UkraineRobotics/Kulya/BODY/Step #1 3D printing & components/CorrectServo.png

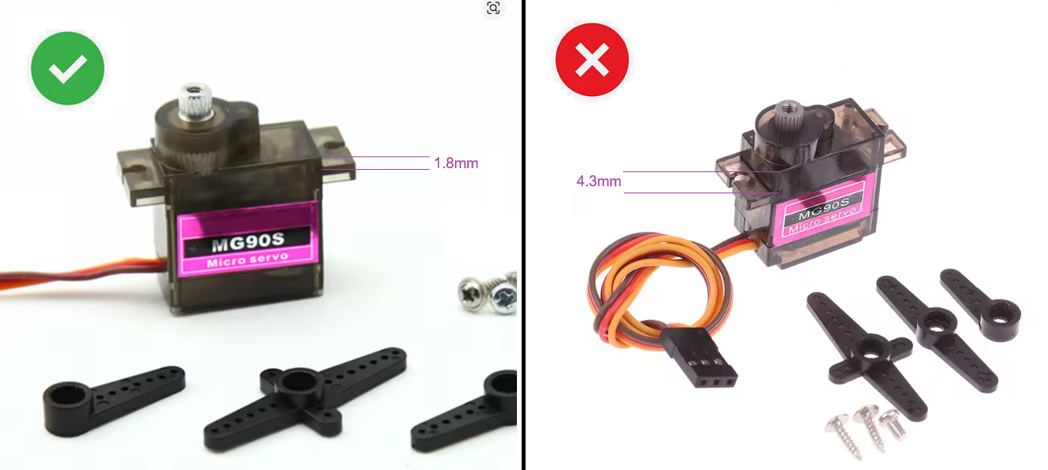
BODY/Step #1 3D printing & components/CorrectServo.png
