UkraineRobotics/Kulya/BATTERY/battery_wirnig.png

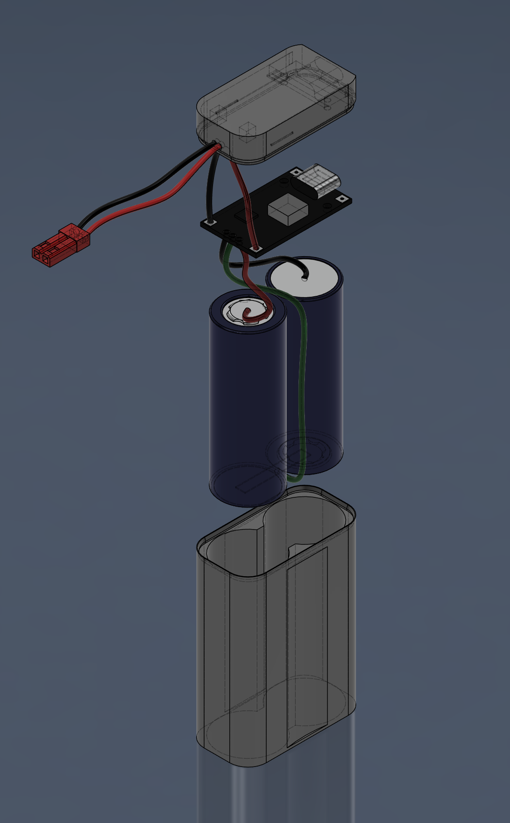
BATTERY/battery_wirnig.png
