UkraineRobotics/Kulya/CONTROLLER/Schematics/#1 rc-wires-length.png

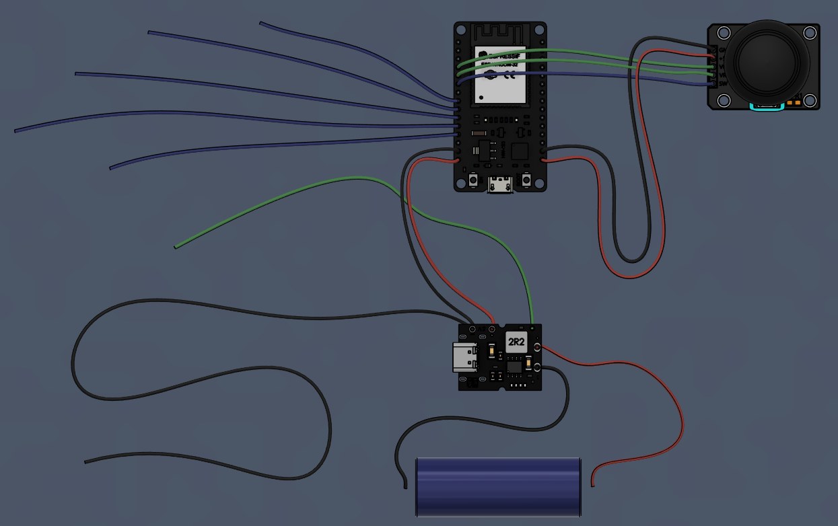
CONTROLLER/Schematics/#1 rc-wires-length.png
