UkraineRobotics/Kulya/CONTROLLER/Schematics/#2 rc-wires-in place.png

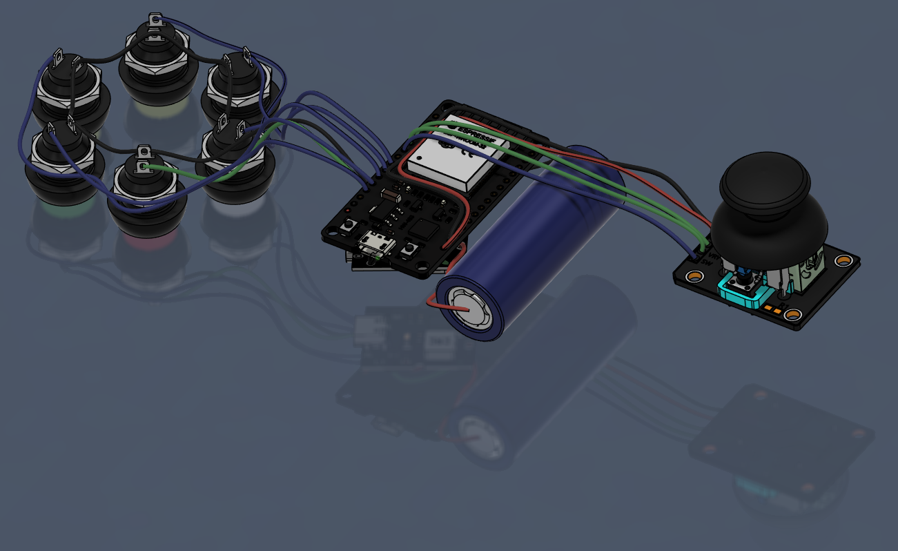
CONTROLLER/Schematics/#2 rc-wires-in place.png
