UkraineRobotics/Kulya/CONTROLLER/Schematics/#3 rc_2.png

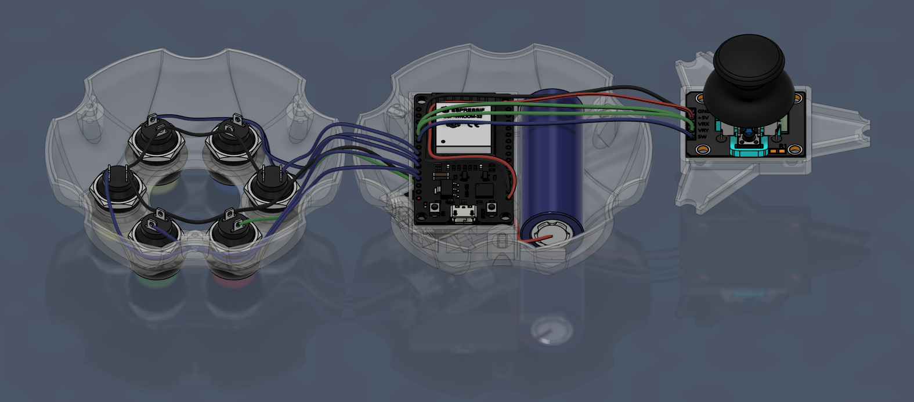
CONTROLLER/Schematics/#3 rc_2.png
