UkraineRobotics/Kulya/CONTROLLER/Schematics/#4 rc3.png

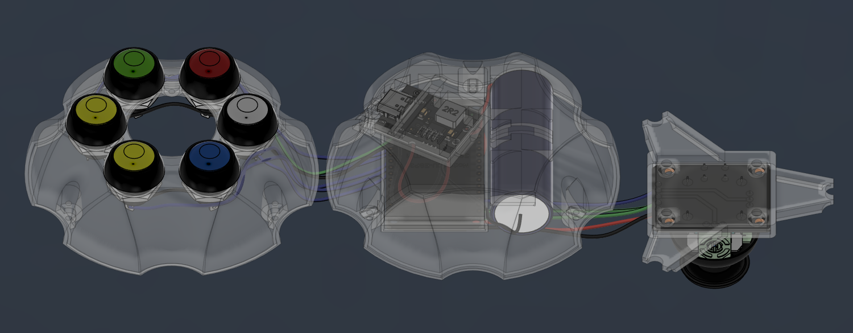
CONTROLLER/Schematics/#4 rc3.png
