UkraineRobotics/Kulya/CONTROLLER/Schematics/rc_all.png

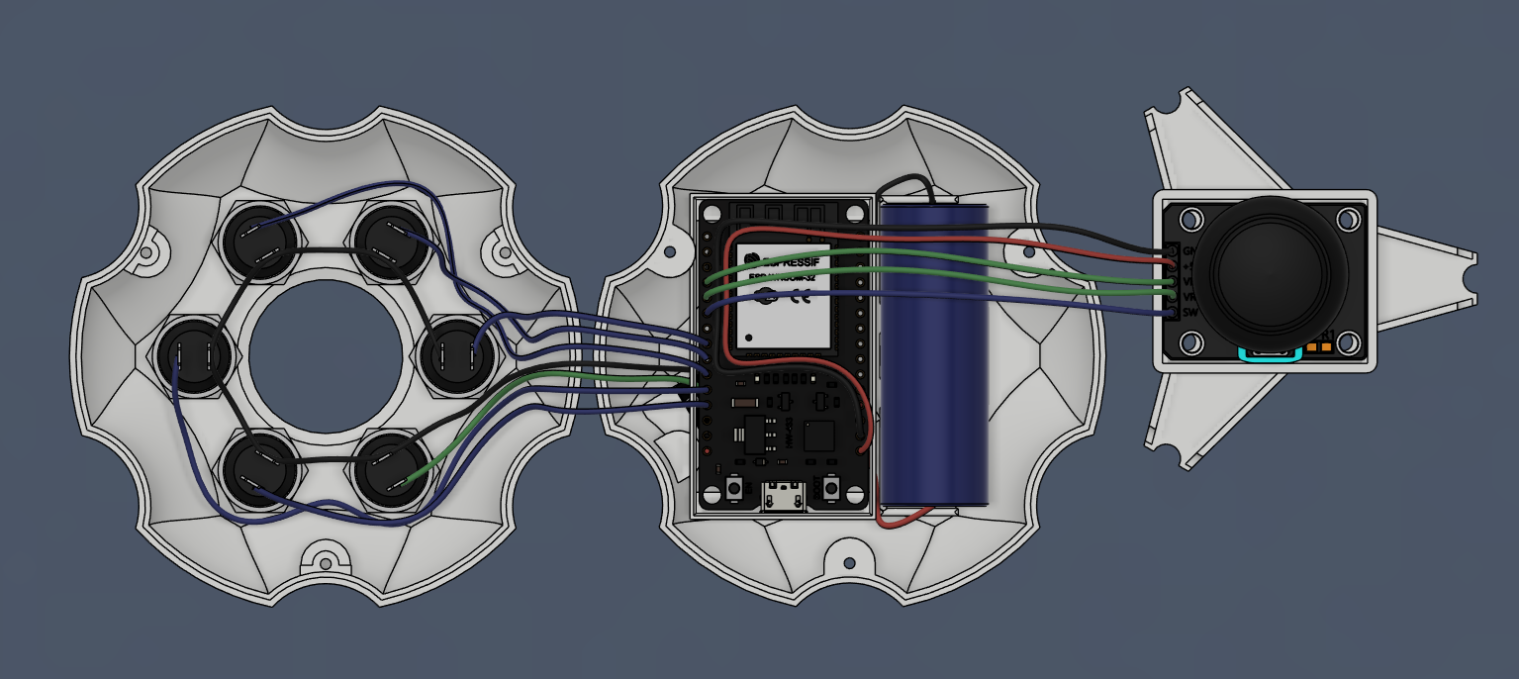
CONTROLLER/Schematics/rc_all.png
