UkraineRobotics/Kulya/BODY/Step #1 3D printing & components/[HEXAPOD KULYA 4.0] Full components list.xlsx

Kulya v4 components
 |  | DIY #1 Body | DIY #2 Battery | DIY #3 Controller
26/24/22/18 awg Mix Stranded Wire Kit | 1 | ✅ | ✅ | ✅ | https://www.aliexpress.com/item/33016312056.html
18500 2000mAh 3.7 V rechargeable battery | 3 | — | ✅ | ✅ | https://www.aliexpress.com/item/1005006411212672.html
Push Button Switch 1712KD | 1 | ✅ | — | — | 1712-KD 2P self-locking rocker switch for DIY robot builds & repairs, flashlight replacement universal decorative on/off button - AliExpress (https://www.aliexpress.com/item/1005010668273964.html)
12mm Waterproof Momentary Push button | 6 | — | — | ✅ | https://www.aliexpress.com/item/32872212158.html
arduino joystick module | 1 | — | — | ✅ | https://www.aliexpress.com/item/1005006195988088.html
esp32 | 2 | ✅ | — | ✅ | https://www.aliexpress.com/item/1005008498639616.html
DC-DC mini560 | 2 | ✅ | ✅ | — | https://www.aliexpress.com/item/1005001426023425.html
type-c BMS | 1 | — | ✅ | — | https://www.aliexpress.com/item/1005004682732678.html
5V 2A Type-C Charge-discharge Integrated Module | 1 | — | ✅ | — | https://www.aliexpress.com/item/1005008401889519.html
10-100pcs Copper Wire JST Male Female Plug Connector 2 Pin | 1 | ✅ | ✅ | ✅ | https://www.aliexpress.com/item/1005010408480405.html?srcSns=sns_Copy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
servo controller USC-1 | 1 | ✅ | — | — | https://www.aliexpress.com/item/32808592882.html
servo MG90s | 20 | ✅ | — | — | https://www.aliexpress.com/item/1005004349047152.html
