UkraineRobotics/Kulya/BATTERY/[HEXAPOD] Battery 3D models/btr_lid.3mf

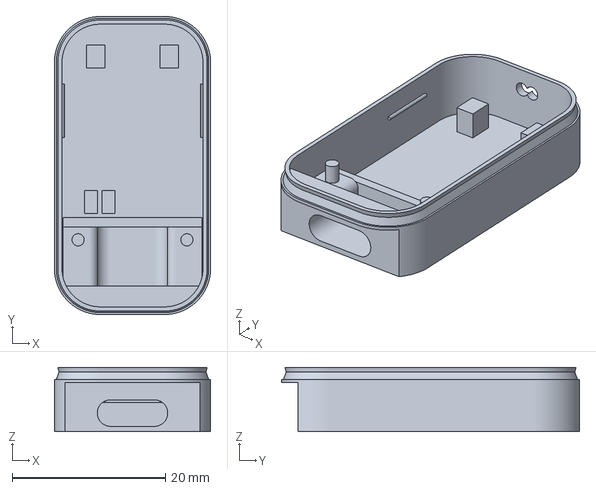
[picture p8: CAD file, 2026-03-12]
BATTERY/[HEXAPOD] Battery 3D models/btr_lid.3mf
20.4 x 38.9 x 8.40 mm
