UkraineRobotics/Kulya/BODY/Step #1 3D printing & components/3D models/femur.3mf

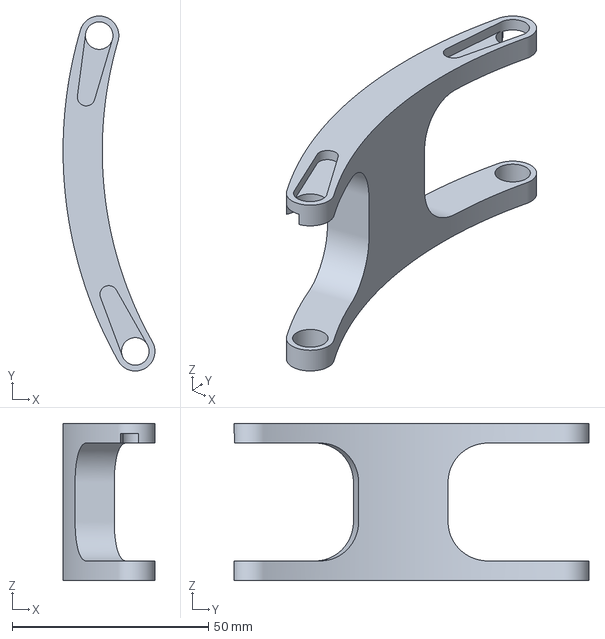
[picture p9: CAD file, 2026-03-12]
BODY/Step #1 3D printing & components/3D models/femur.3mf
23.4 x 90.4 x 40.0 mm
