UkraineRobotics/Kulya/BODY/Step #1 3D printing & components/Print Kulya_v4_all_models.3mf

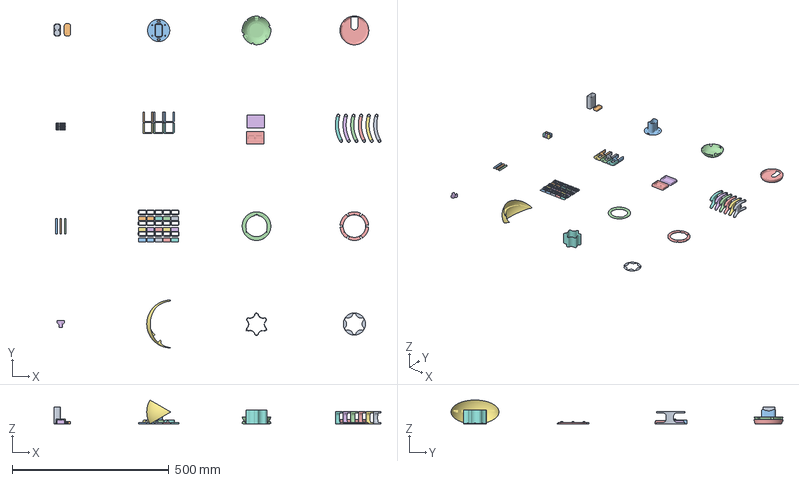
[picture p10: CAD file, 2026-03-12]
BODY/Step #1 3D printing & components/Print Kulya_v4_all_models.3mf
1042.7 x 1058.5 x 76.3 mm
btr_case
btr_lid
battery_module
cap_bottom
cap_top
connector x 6
leg-seg-base-short x 6
dcdc_pocket
esp_pocket
femur x 6
pole1 x 3
Assembly x 15
base_lower_ring
RING_top
switch holder
Tibia
outer_shell
tubu_cap
