UkraineRobotics/Kulya/BATTERY/[HEXAPOD] Battery 3D models/btr_case.3mf

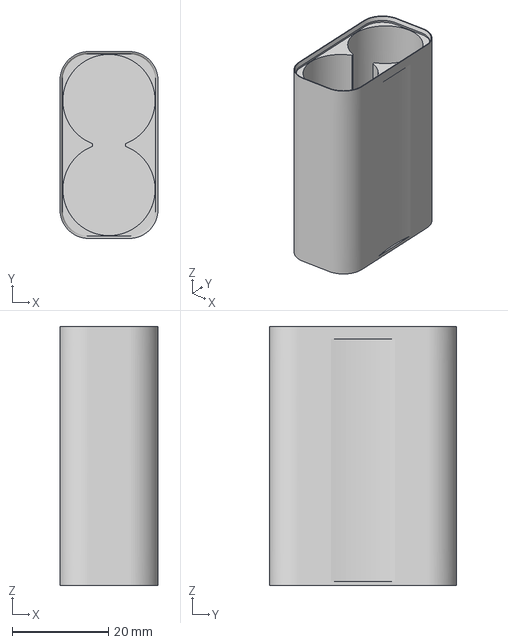
[picture p12: CAD file, 2026-03-12]
BATTERY/[HEXAPOD] Battery 3D models/btr_case.3mf
20.4 x 38.9 x 53.9 mm
