UkraineRobotics/Kulya/BODY/Step #1 3D printing & components/3D models/CAP_top_enforced.3mf

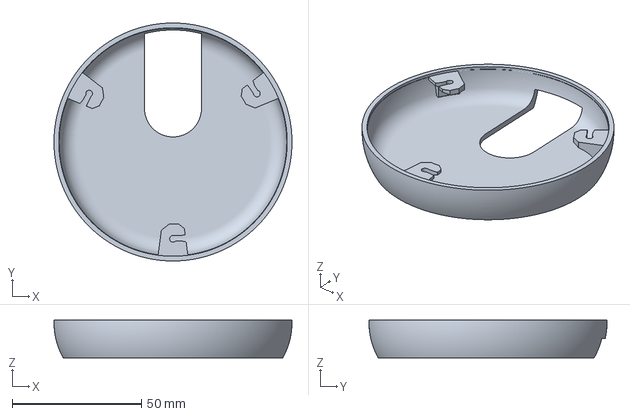
[picture p13: CAD file, 2026-03-12]
BODY/Step #1 3D printing & components/3D models/CAP_top_enforced.3mf
92.0 x 92.0 x 14.5 mm
