UkraineRobotics/Kulya/CONTROLLER/RemoteControl 3D models/RC_Bottom.3mf

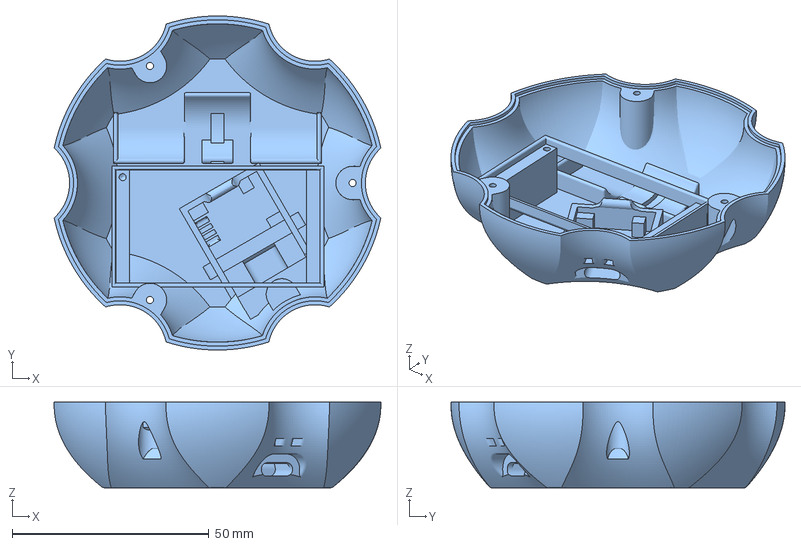
[picture p14: CAD file, 2026-03-12]
CONTROLLER/RemoteControl 3D models/RC_Bottom.3mf
83.1 x 85.0 x 21.8 mm
