UkraineRobotics/Kulya/BODY/Step #1 3D printing & components/3D models/tubus_cap.3mf

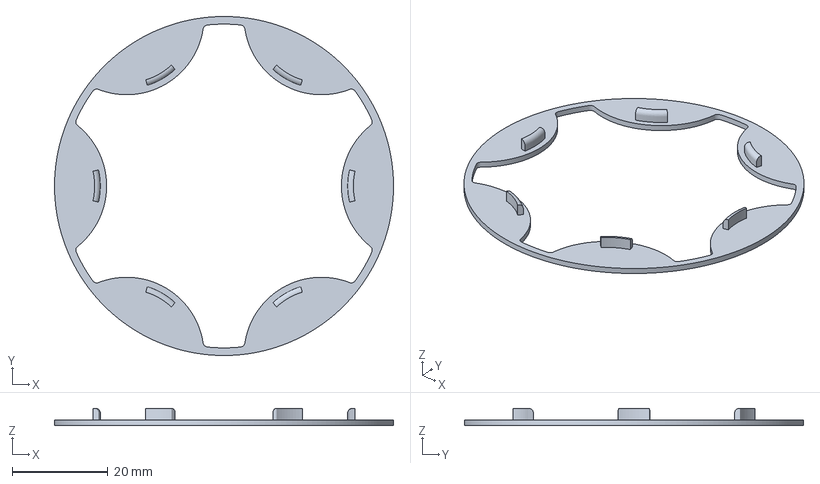
[picture p15: CAD file, 2026-03-12]
BODY/Step #1 3D printing & components/3D models/tubus_cap.3mf
70.9 x 70.9 x 3.60 mm
