UkraineRobotics/Kulya/CONTROLLER/RemoteControl 3D models/RC_Joystick floor.3mf

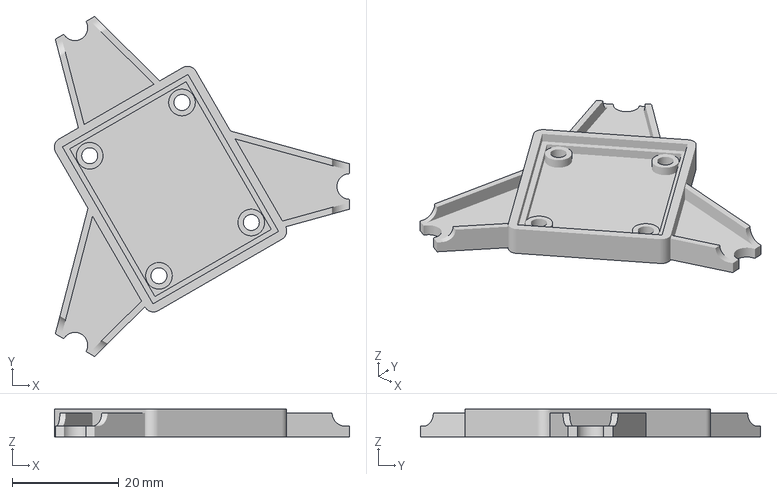
[picture p16: CAD file, 2026-03-12]
CONTROLLER/RemoteControl 3D models/RC_Joystick floor.3mf
55.4 x 63.8 x 5.20 mm
