UkraineRobotics/Kulya/BODY/Step #1 3D printing & components/3D models/ring_top.3mf

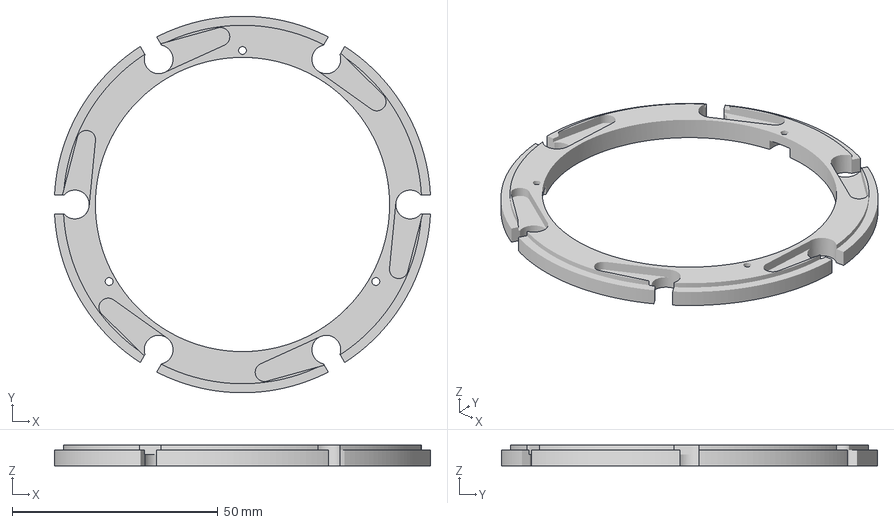
[picture p17: CAD file, 2026-03-12]
BODY/Step #1 3D printing & components/3D models/ring_top.3mf
91.4 x 91.5 x 5.00 mm
