UkraineRobotics/Kulya/BODY/Step #1 3D printing & components/3D models/tubus.3mf

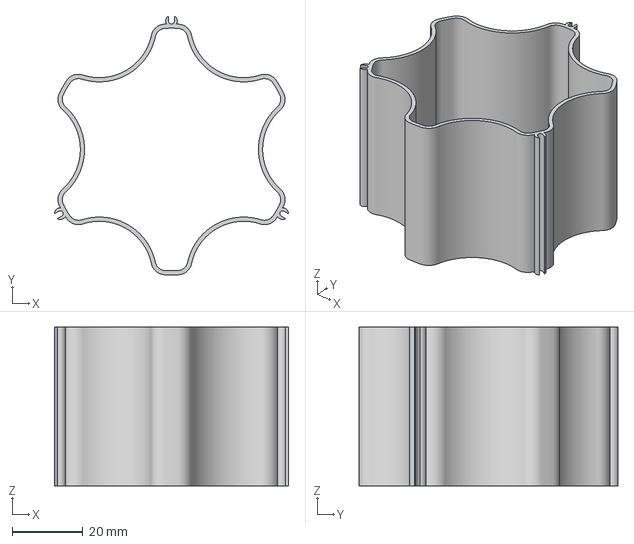
[picture p18: CAD file, 2026-03-12]
BODY/Step #1 3D printing & components/3D models/tubus.3mf
66.1 x 73.1 x 44.8 mm
