UkraineRobotics/Kulya/BODY/Step #1 3D printing & components/3D models/connector.3mf

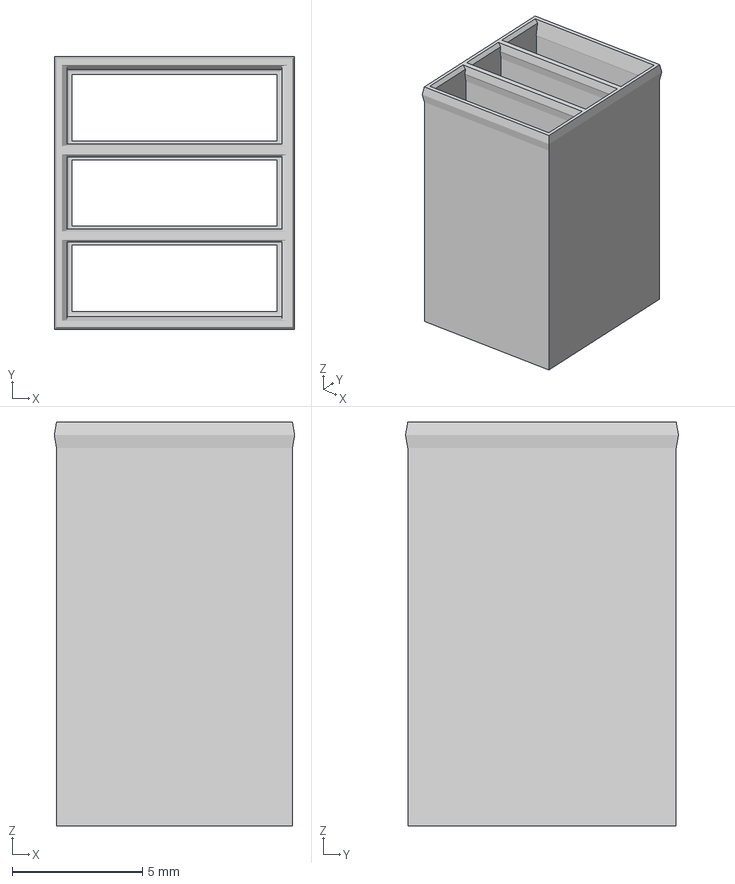
[picture p19: CAD file, 2026-03-12]
BODY/Step #1 3D printing & components/3D models/connector.3mf
9.23 x 10.5 x 15.5 mm
