UkraineRobotics/Kulya/BODY/Step #1 3D printing & components/3D models/btr_module.3mf

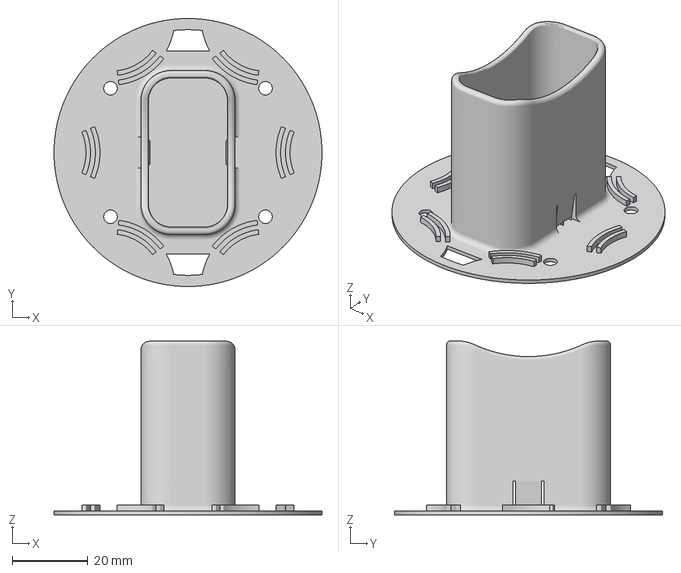
[picture p21: CAD file, 2026-03-12]
BODY/Step #1 3D printing & components/3D models/btr_module.3mf
70.9 x 70.9 x 46.0 mm
