UkraineRobotics/Kulya/BODY/Step #1 3D printing & components/3D models/switch holder.3mf

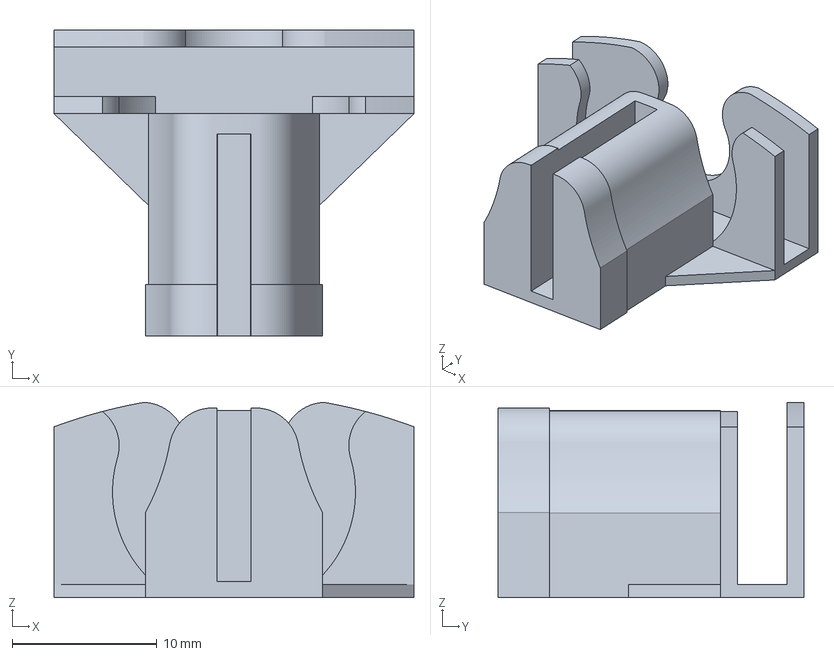
[picture p22: CAD file, 2026-03-12]
BODY/Step #1 3D printing & components/3D models/switch holder.3mf
24.9 x 21.2 x 13.5 mm
