UkraineRobotics/Kulya/BODY/Step #1 3D printing & components/3D models/esp_pocket.3mf

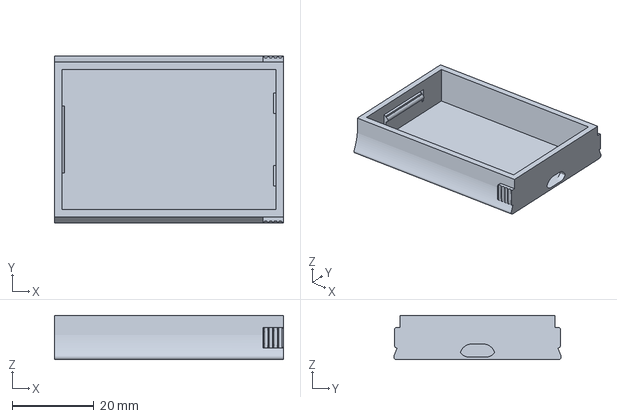
[picture p23: CAD file, 2026-03-12]
BODY/Step #1 3D printing & components/3D models/esp_pocket.3mf
56.1 x 41.0 x 10.8 mm
