UkraineRobotics/Kulya/BODY/Step #1 3D printing & components/3D models/Pin.3mf

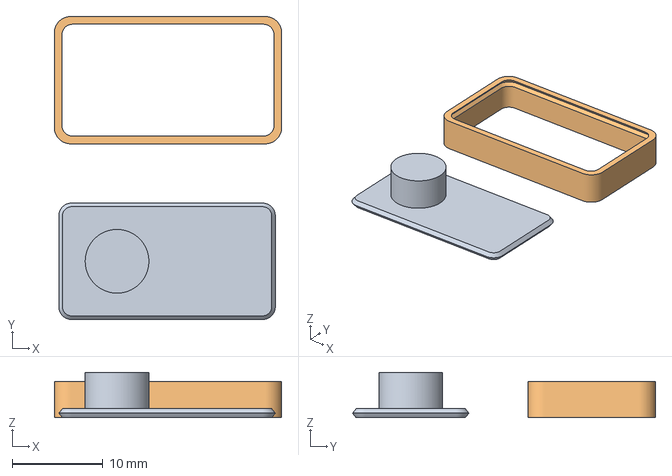
[picture p24: CAD file, 2026-03-12]
BODY/Step #1 3D printing & components/3D models/Pin.3mf
25.0 x 33.3 x 5.00 mm
Pin_inner
pin_outer
