UkraineRobotics/Kulya/BODY/Step #1 3D printing & components/3D models/ring_bottom.3mf

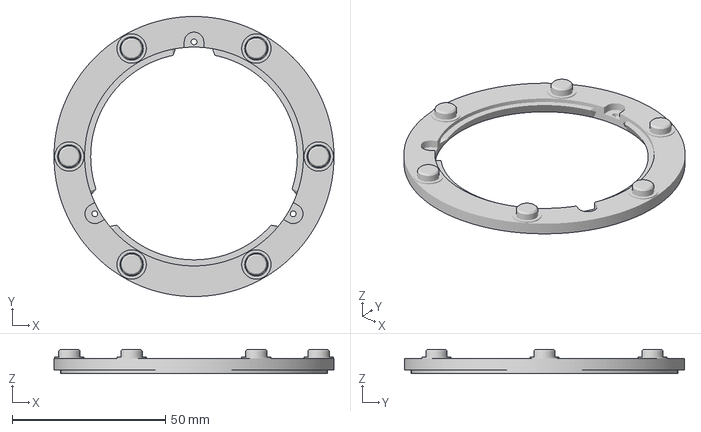
[picture p25: CAD file, 2026-03-12]
BODY/Step #1 3D printing & components/3D models/ring_bottom.3mf
91.5 x 91.5 x 7.90 mm
