UkraineRobotics/Kulya/BODY/Step #1 3D printing & components/3D models/coxa.3mf

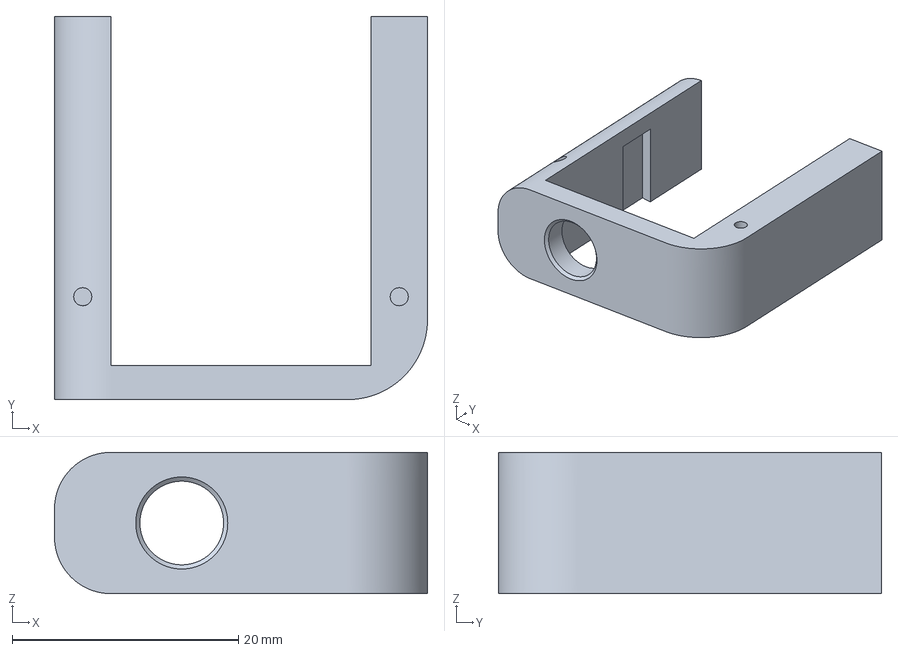
[picture p26: CAD file, 2026-03-12]
BODY/Step #1 3D printing & components/3D models/coxa.3mf
33.0 x 33.9 x 12.5 mm
