UkraineRobotics/Kulya/BODY/Step #1 3D printing & components/3D models/pillar.3mf

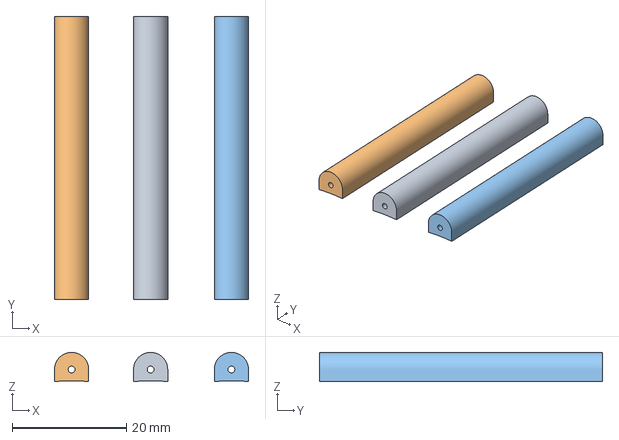
[picture p27: CAD file, 2026-03-12]
BODY/Step #1 3D printing & components/3D models/pillar.3mf
34.0 x 49.6 x 5.11 mm
pole1 x 3
