UkraineRobotics/Kulya/BODY/Step #1 3D printing & components/3D models/Tibia.3mf

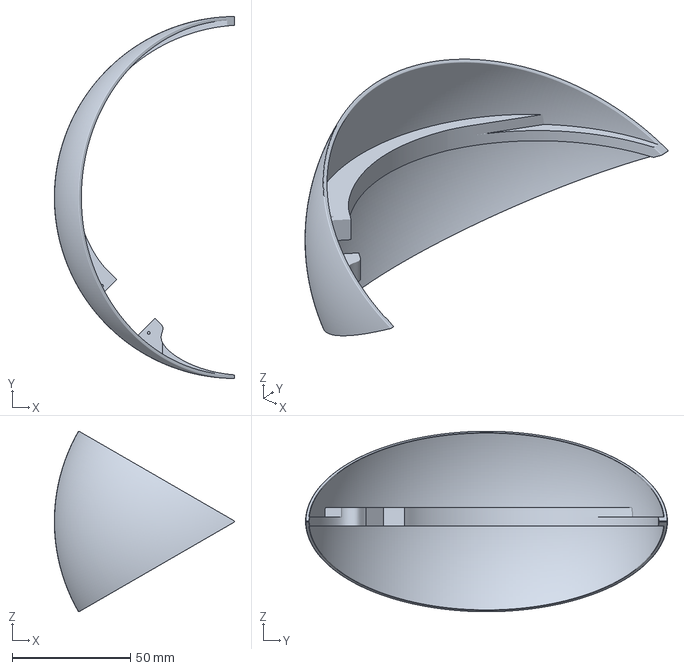
[picture p28: CAD file, 2026-03-12]
BODY/Step #1 3D printing & components/3D models/Tibia.3mf
76.2 x 153.0 x 76.3 mm
