UkraineRobotics/Kulya/BODY/Step #1 3D printing & components/3D models/CAP_bottom.3mf

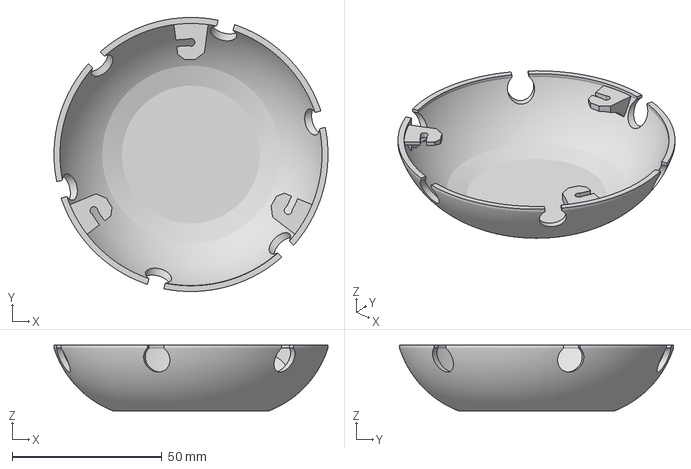
[picture p29: CAD file, 2026-03-12]
BODY/Step #1 3D printing & components/3D models/CAP_bottom.3mf
91.5 x 91.5 x 22.0 mm
