UkraineRobotics/Kulya/BODY/Step #3 Software/Kulya code installation.pdf

0. Install usb driver

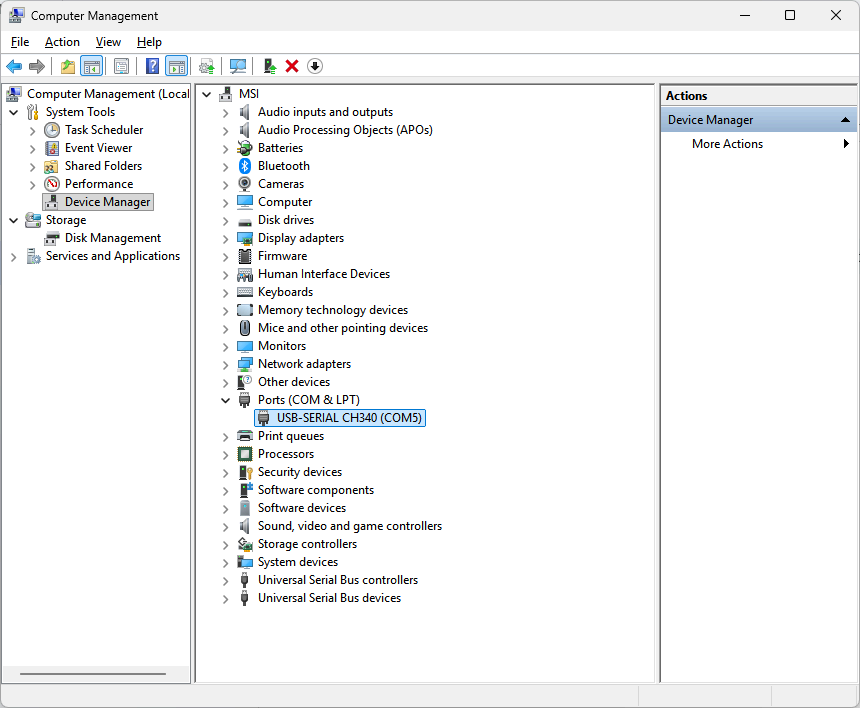
[picture p30: figure]

1. Instal Thonny IDE
2. Install micropython on esp32

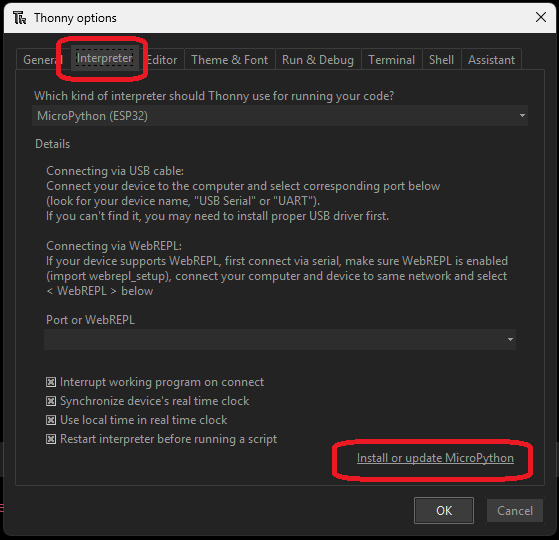
[picture p31: figure]

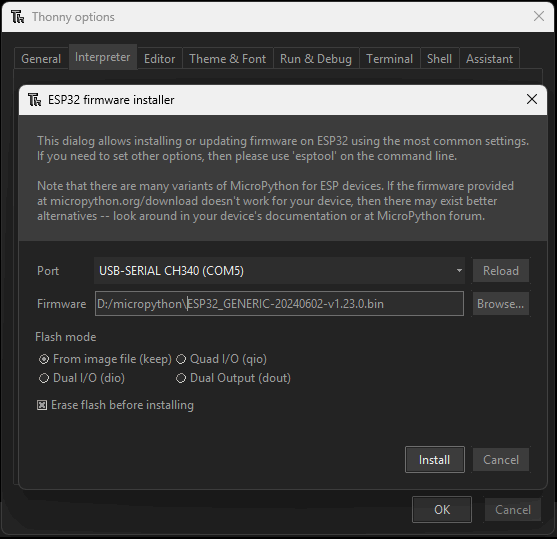
[picture p32: figure]

3 connect to esp32 and copy code

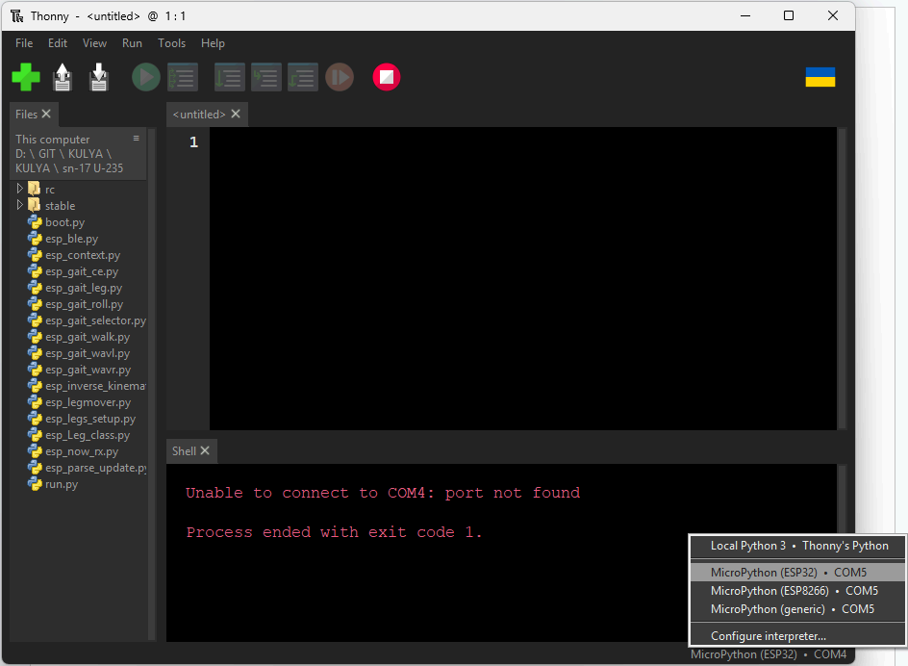
[picture p33: figure]

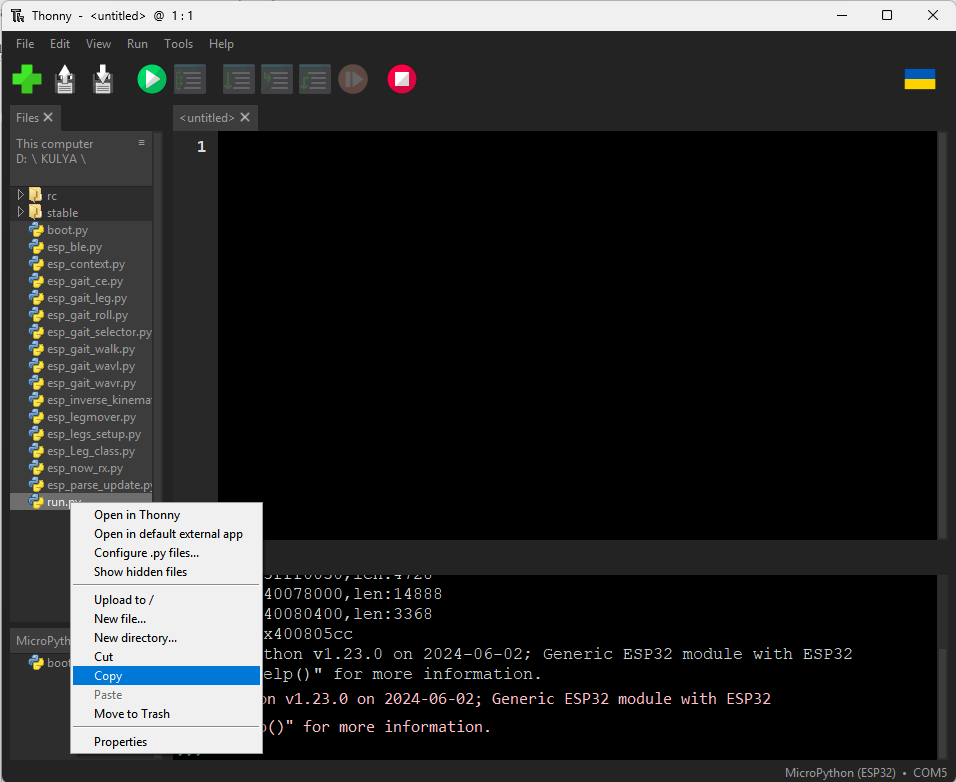
[picture p34: figure]
