UkraineRobotics/Kulya/BODY/Step #1 3D printing & components/Print table overview.png

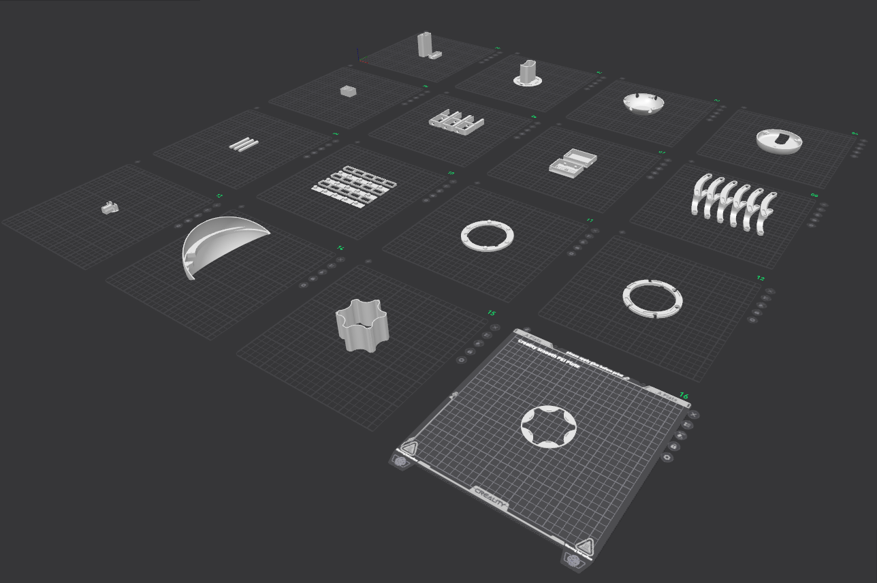
BODY/Step #1 3D printing & components/Print table overview.png
