UkraineRobotics/Kulya/BODY/Step #2 Assemble/kulya_wiring.png

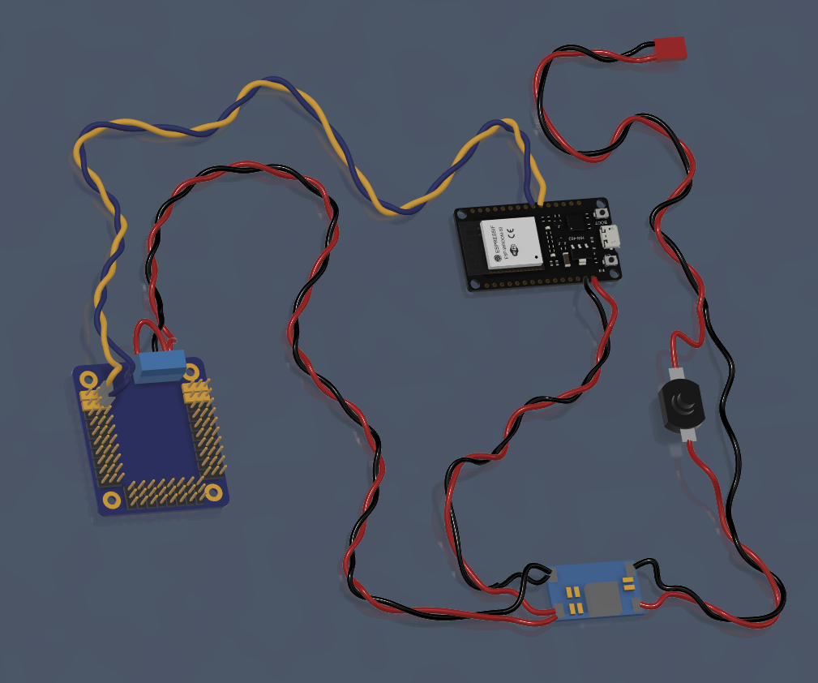
BODY/Step #2 Assemble/kulya_wiring.png
